go4retro/Nu8500/pcb/Nu8502 PCB.png

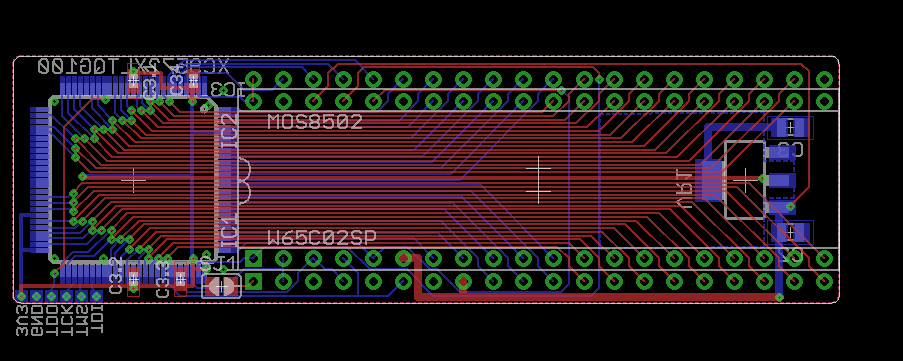
pcb/Nu8502 PCB.png
