go4retro/Nu8500/pcb/Nu8502 Schematic (CPU).png

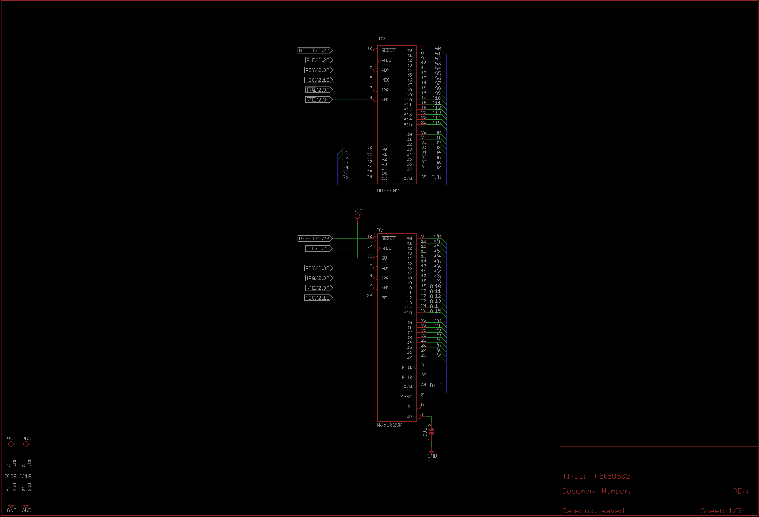
pcb/Nu8502 Schematic (CPU).png
