go4retro/Nu8500/pcb/Nu8502 Schematic (Logic).png

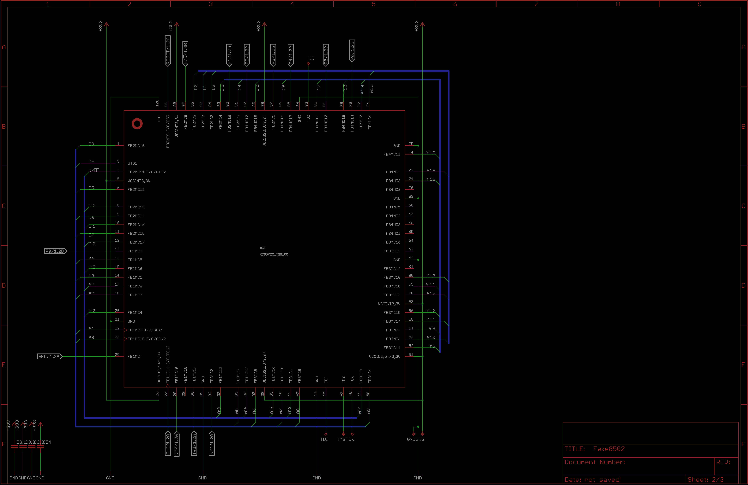
pcb/Nu8502 Schematic (Logic).png
