go4retro/Nu8500/pcb/Nu8502 Schematic (Power).png

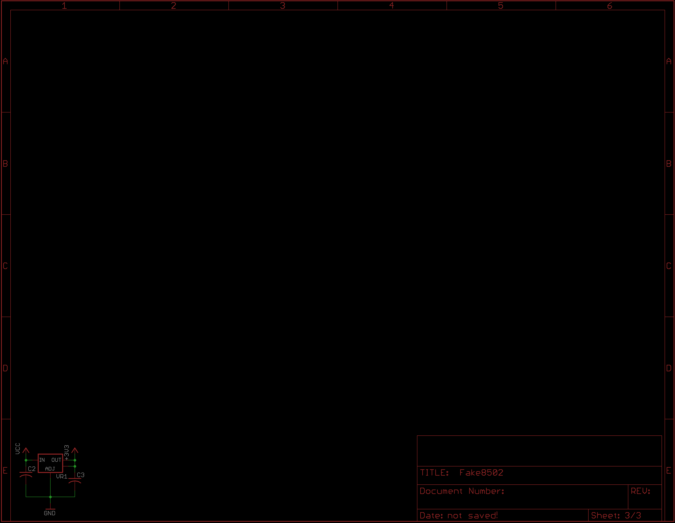
pcb/Nu8502 Schematic (Power).png
