go4retro/Nu8500/pcb/Nu8502.brd

## EAGLE design pcb/Nu8502.brd (2020-01-10)

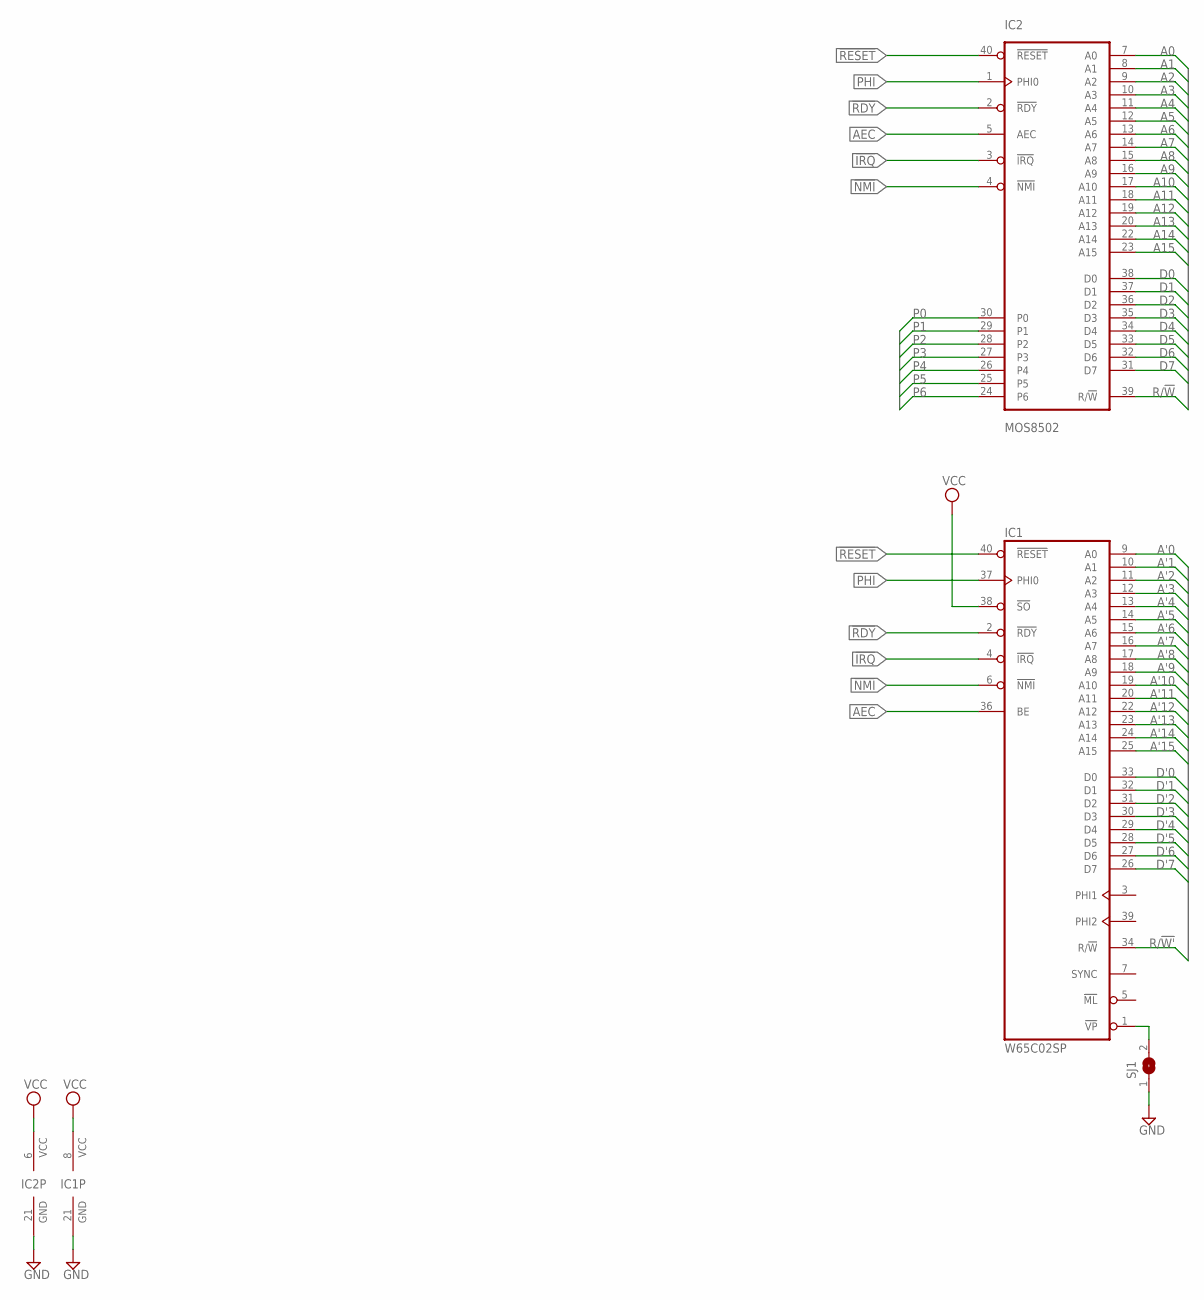
[picture p5: schematic Nu8502.sch, sheet 1, CPU]

Parts:
IC1: W65C02SP; DIL40-ROUNDPAD
IC2: MOS8502; DIL40-ROUNDPAD
SJ1: SJ

Connections:
!IRQ: IC1.4 (!IRQ), IC2.3 (!IRQ); also elsewhere on the board
!NMI: IC1.6 (!NMI), IC2.4 (!NMI); also elsewhere on the board
!RDY: IC1.2 (!RDY), IC2.2 (!RDY); also elsewhere on the board
!RESET: IC1.40 (!RESET), IC2.40 (!RESET); also elsewhere on the board
A0: IC2.7 (A0); also elsewhere on the board
A1: IC2.8 (A1); also elsewhere on the board
A2: IC2.9 (A2); also elsewhere on the board
A3: IC2.10 (A3); also elsewhere on the board
A4: IC2.11 (A4); also elsewhere on the board
A5: IC2.12 (A5); also elsewhere on the board
A6: IC2.13 (A6); also elsewhere on the board
A7: IC2.14 (A7); also elsewhere on the board
A8: IC2.15 (A8); also elsewhere on the board
A9: IC2.16 (A9); also elsewhere on the board
A10: IC2.17 (A10); also elsewhere on the board
A11: IC2.18 (A11); also elsewhere on the board
A12: IC2.19 (A12); also elsewhere on the board
A13: IC2.20 (A13); also elsewhere on the board
A14: IC2.22 (A14); also elsewhere on the board
A15: IC2.23 (A15); also elsewhere on the board
A'0: IC1.9 (A0); also elsewhere on the board
A'1: IC1.10 (A1); also elsewhere on the board
A'2: IC1.11 (A2); also elsewhere on the board
A'3: IC1.12 (A3); also elsewhere on the board
A'4: IC1.13 (A4); also elsewhere on the board
A'5: IC1.14 (A5); also elsewhere on the board
A'6: IC1.15 (A6); also elsewhere on the board
A'7: IC1.16 (A7); also elsewhere on the board
A'8: IC1.17 (A8); also elsewhere on the board
A'9: IC1.18 (A9); also elsewhere on the board
A'10: IC1.19 (A10); also elsewhere on the board
A'11: IC1.20 (A11); also elsewhere on the board
A'12: IC1.22 (A12); also elsewhere on the board
A'13: IC1.23 (A13); also elsewhere on the board
A'14: IC1.24 (A14); also elsewhere on the board
A'15: IC1.25 (A15); also elsewhere on the board
AEC: IC1.36 (BE), IC2.5 (AEC); also elsewhere on the board
D0: IC2.38 (D0); also elsewhere on the board
D1: IC2.37 (D1); also elsewhere on the board
D2: IC2.36 (D2); also elsewhere on the board
D3: IC2.35 (D3); also elsewhere on the board
D4: IC2.34 (D4); also elsewhere on the board
D5: IC2.33 (D5); also elsewhere on the board
D6: IC2.32 (D6); also elsewhere on the board
D7: IC2.31 (D7); also elsewhere on the board
D'0: IC1.33 (D0); also elsewhere on the board
D'1: IC1.32 (D1); also elsewhere on the board
D'2: IC1.31 (D2); also elsewhere on the board
D'3: IC1.30 (D3); also elsewhere on the board
D'4: IC1.29 (D4); also elsewhere on the board
D'5: IC1.28 (D5); also elsewhere on the board
D'6: IC1.27 (D6); also elsewhere on the board
D'7: IC1.26 (D7); also elsewhere on the board
GND: IC1.21 (GND), IC2.21 (GND), SJ1.1; also elsewhere on the board
unnamed: IC1.1 (!VP), SJ1.2
P0: IC2.30 (P0); also elsewhere on the board
P1: IC2.29 (P1); also elsewhere on the board
P2: IC2.28 (P2); also elsewhere on the board
P3: IC2.27 (P3); also elsewhere on the board
P4: IC2.26 (P4); also elsewhere on the board
P5: IC2.25 (P5); also elsewhere on the board
P6: IC2.24 (P6); also elsewhere on the board
PHI: IC1.37 (PHI0), IC2.1 (PHI0); also elsewhere on the board
R/!W: IC2.39 (R/!W); also elsewhere on the board
R/!W': IC1.34 (R/!W); also elsewhere on the board
VCC: IC1.8 (VCC), IC1.38 (!SO), IC2.6 (VCC); also elsewhere on the board

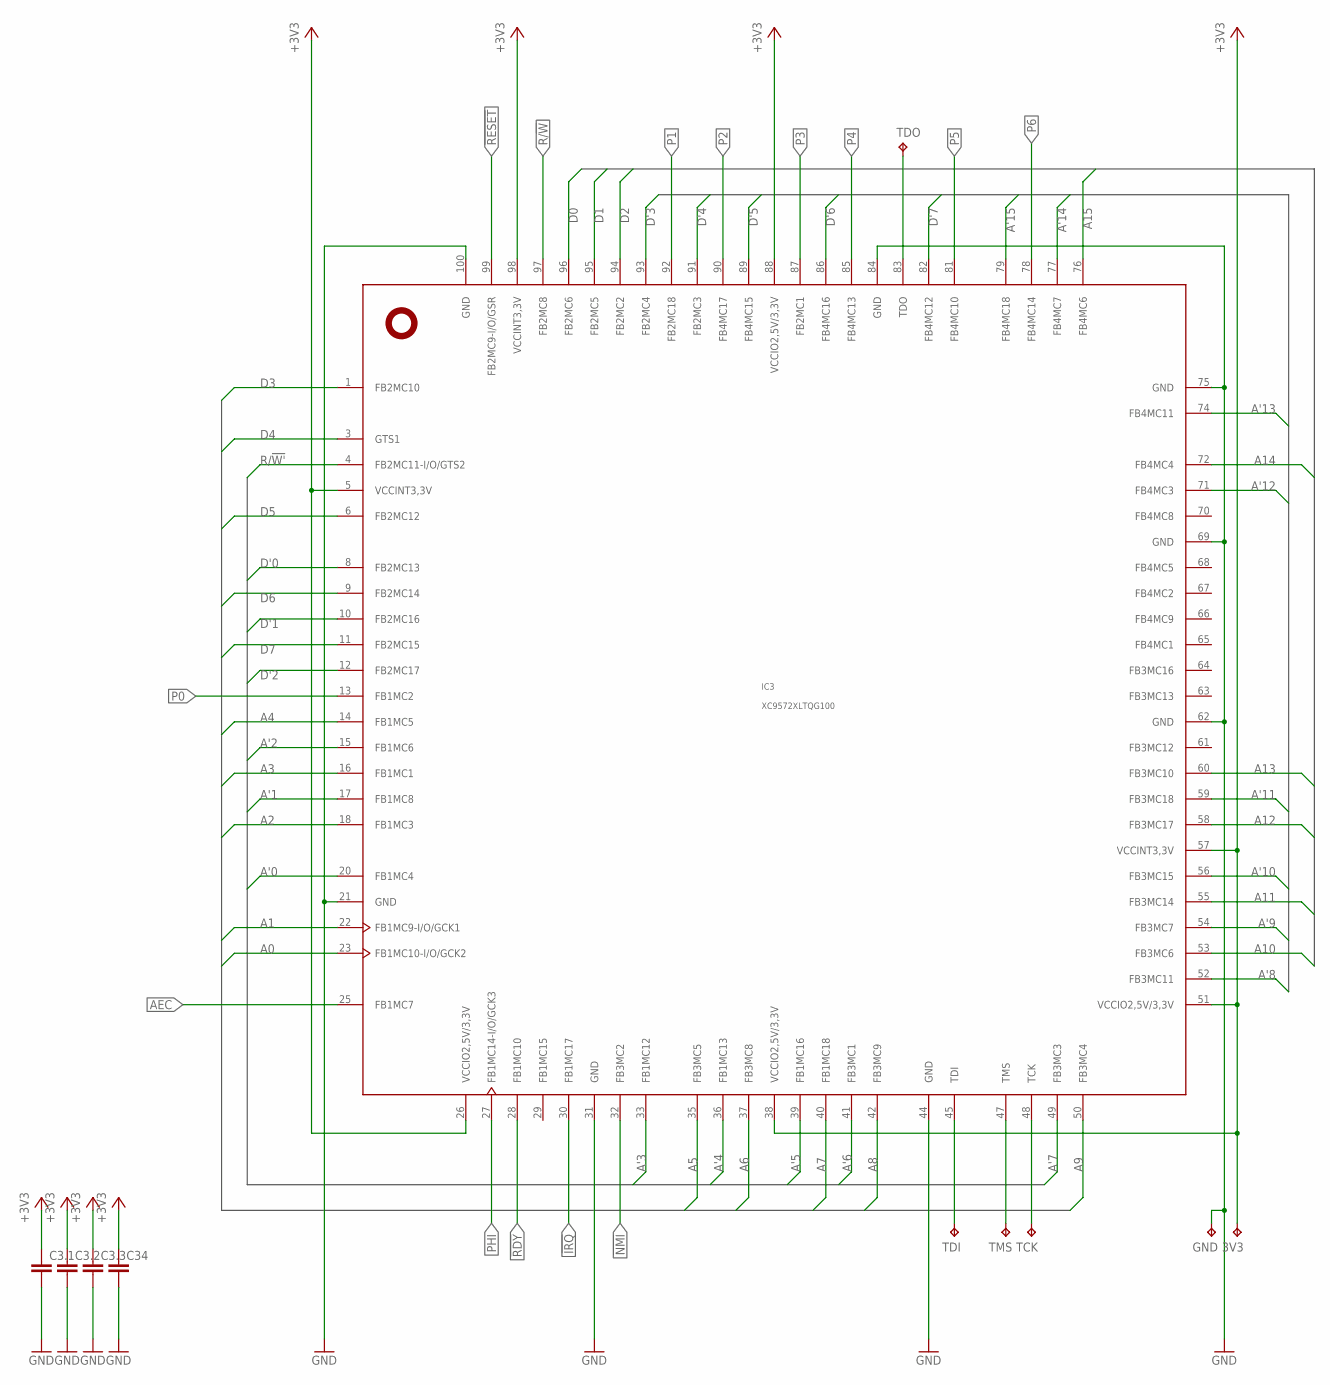
[picture p6: schematic Nu8502.sch, sheet 2, LOGIC]

Parts:
3V3: TPTP10SQ; TP10SQ
C3.1, C3.2, C3.3, C34: C-EUC0402; C0402
GND: TPTP10SQ; TP10SQ
IC3: XC9572XLTQG100; TQFP100
TCK: TPTP10SQ; TP10SQ
TDI: TPTP10SQ; TP10SQ
TDO: TPTP10SQ; TP10SQ
TMS: TPTP10SQ; TP10SQ

Connections:
!IRQ: IC3.30 (FB1MC17); also elsewhere on the board
!NMI: IC3.32 (FB3MC2); also elsewhere on the board
!RDY: IC3.28 (FB1MC10); also elsewhere on the board
!RESET: IC3.99 (FB2MC9-I/O/GSR); also elsewhere on the board
+3V3: 3V3.TP, C3.1.1, C3.2.1, C3.3.1, C34.1, IC3.5 (VCCINT3,3V), IC3.26 (VCCIO2,5V/3,3V), IC3.38 (VCCIO2,5V/3,3V), IC3.51 (VCCIO2,5V/3,3V), IC3.57 (VCCINT3,3V), IC3.88 (VCCIO2,5V/3,3V), IC3.98 (VCCINT3,3V); also elsewhere on the board
A0: IC3.23 (FB1MC10-I/O/GCK2); also elsewhere on the board
A1: IC3.22 (FB1MC9-I/O/GCK1); also elsewhere on the board
A2: IC3.18 (FB1MC3); also elsewhere on the board
A3: IC3.16 (FB1MC1); also elsewhere on the board
A4: IC3.14 (FB1MC5); also elsewhere on the board
A5: IC3.35 (FB3MC5); also elsewhere on the board
A6: IC3.37 (FB3MC8); also elsewhere on the board
A7: IC3.40 (FB1MC18); also elsewhere on the board
A8: IC3.42 (FB3MC9); also elsewhere on the board
A9: IC3.50 (FB3MC4); also elsewhere on the board
A10: IC3.53 (FB3MC6); also elsewhere on the board
A11: IC3.55 (FB3MC14); also elsewhere on the board
A12: IC3.58 (FB3MC17); also elsewhere on the board
A13: IC3.60 (FB3MC10); also elsewhere on the board
A14: IC3.72 (FB4MC4); also elsewhere on the board
A15: IC3.76 (FB4MC6); also elsewhere on the board
A'0: IC3.20 (FB1MC4); also elsewhere on the board
A'1: IC3.17 (FB1MC8); also elsewhere on the board
A'2: IC3.15 (FB1MC6); also elsewhere on the board
A'3: IC3.33 (FB1MC12); also elsewhere on the board
A'4: IC3.36 (FB1MC13); also elsewhere on the board
A'5: IC3.39 (FB1MC16); also elsewhere on the board
A'6: IC3.41 (FB3MC1); also elsewhere on the board
A'7: IC3.49 (FB3MC3); also elsewhere on the board
A'8: IC3.52 (FB3MC11); also elsewhere on the board
A'9: IC3.54 (FB3MC7); also elsewhere on the board
A'10: IC3.56 (FB3MC15); also elsewhere on the board
A'11: IC3.59 (FB3MC18); also elsewhere on the board
A'12: IC3.71 (FB4MC3); also elsewhere on the board
A'13: IC3.74 (FB4MC11); also elsewhere on the board
A'14: IC3.77 (FB4MC7); also elsewhere on the board
A'15: IC3.79 (FB4MC18); also elsewhere on the board
AEC: IC3.25 (FB1MC7); also elsewhere on the board
D0: IC3.96 (FB2MC6); also elsewhere on the board
D1: IC3.95 (FB2MC5); also elsewhere on the board
D2: IC3.94 (FB2MC2); also elsewhere on the board
D3: IC3.1 (FB2MC10); also elsewhere on the board
D4: IC3.3 (GTS1); also elsewhere on the board
D5: IC3.6 (FB2MC12); also elsewhere on the board
D6: IC3.9 (FB2MC14); also elsewhere on the board
D7: IC3.11 (FB2MC15); also elsewhere on the board
D'0: IC3.8 (FB2MC13); also elsewhere on the board
D'1: IC3.10 (FB2MC16); also elsewhere on the board
D'2: IC3.12 (FB2MC17); also elsewhere on the board
D'3: IC3.93 (FB2MC4); also elsewhere on the board
D'4: IC3.91 (FB2MC3); also elsewhere on the board
D'5: IC3.89 (FB4MC15); also elsewhere on the board
D'6: IC3.86 (FB4MC16); also elsewhere on the board
D'7: IC3.82 (FB4MC12); also elsewhere on the board
GND: C3.1.2, C3.2.2, C3.3.2, C34.2, GND.TP, IC3.21 (GND), IC3.31 (GND), IC3.44 (GND), IC3.62 (GND), IC3.69 (GND), IC3.75 (GND), IC3.84 (GND), IC3.100 (GND); also elsewhere on the board
unnamed: IC3.48 (TCK), TCK.TP
unnamed: IC3.47 (TMS), TMS.TP
unnamed: IC3.45 (TDI), TDI.TP
unnamed: IC3.83 (TDO), TDO.TP
P0: IC3.13 (FB1MC2); also elsewhere on the board
P1: IC3.92 (FB2MC18); also elsewhere on the board
P2: IC3.90 (FB4MC17); also elsewhere on the board
P3: IC3.87 (FB2MC1); also elsewhere on the board
P4: IC3.85 (FB4MC13); also elsewhere on the board
P5: IC3.81 (FB4MC10); also elsewhere on the board
P6: IC3.78 (FB4MC14); also elsewhere on the board
PHI: IC3.27 (FB1MC14-I/O/GCK3); also elsewhere on the board
R/!W: IC3.97 (FB2MC8); also elsewhere on the board
R/!W': IC3.4 (FB2MC11-I/O/GTS2); also elsewhere on the board

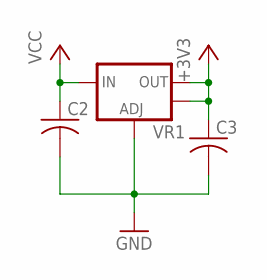
[picture p7: schematic Nu8502.sch, sheet 3, POWER]

Parts:
C2, C3: C-USC0805; C0805
VR1: V_REG_LM1117SOT223; SOT223

Connections:
+3V3: C3.1, VR1.2 (OUT), VR1.4 (OUT); also elsewhere on the board
GND: C2.2, C3.2, VR1.1 (ADJ); also elsewhere on the board
VCC: C2.1, VR1.3 (IN); also elsewhere on the board

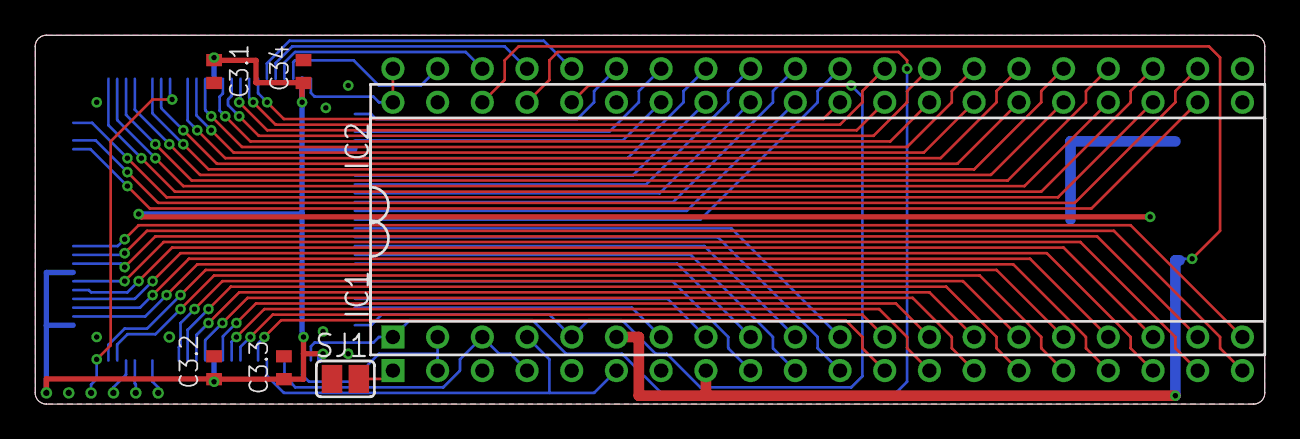
[picture p8: board Nu8502.brd from above]

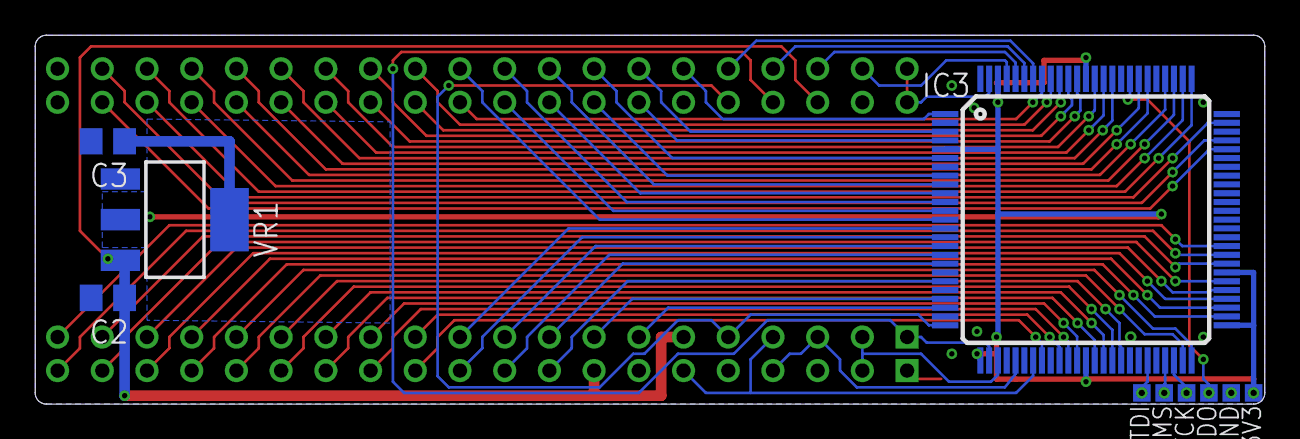
[picture p9: board Nu8502.brd from below]

Board: 2 copper layers, 69.8 x 21.0 mm, 17 parts (10 on the bottom side), 71 nets.
