go4retro/Nu8500/(commit log)

2018-07-13 Fixed port definitions
    [Fake8502.brd, Fake8502.sch]
2020-01-10 Created GFX for schematic and PCB
    [Fake8502.brd, Fake8502.sch]
2020-01-10 Rename project
    [Nu8502.brd, Nu8502.sch]
